nodang/micromouse_hara/README.md

# Micromouse HARA
HARA name comes from [GARA](https://github.com/nodang/LineTracer_Gara).  

HARA is made by [MAZE](https://mazehz.cafe24.com/zbxe/) [25th Roh](https://github.com/nodang) & [28th Cho](https://github.com/cho-hm02123)
