nodang/micromouse_hara/Hara_pcb/Hara/SolidWorks/board_D.DXF

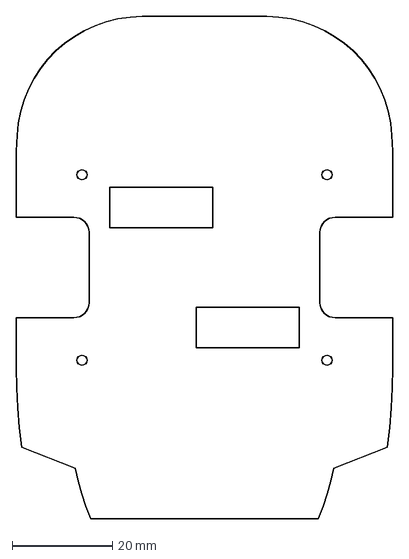
[picture p1: CAD file, 2023-11-28]
Hara_pcb/Hara/SolidWorks/board_D.DXF
75.0 x 100.0 mm
