nodang/micromouse_hara/(list of files, drawings)

Other design files:
Hara_pcb/Hara_v0.4 - cooper-final2.pcb
Hara_pcb/Hara_v0.4 - shape-final.pcb
