nodang/micromouse_hara/2809_hara/main/Variable.h

//###########################################################################
//
// FILE		: Variable.h
//
// TITLE	: Variable.h file.
//
// Author	: Yuk Keun Ho
//
// Company	: Maze & Hz
//
//###########################################################################
// $Release Date: 2011.10.6 $
//###########################################################################



#ifdef _MAIN_
	#ifndef __VARIABLE_EXT__
		#define __VARIABLE_EXT__
	#endif
#else
	#ifndef __VARIABLE_EXT__
		#define __VARIABLE_EXT__	extern
	#endif
#endif	

//==========================================================================//
//                           ROBOT ENVIROMENT                               //
//==========================================================================//

#define BLOCK_WIDTH				_IQ17(180.0)
#define HALF_BLOCK_WIDTH		_IQ17(90.0)
#define BLOCK_WIDTH_DIV2		_IQ17(90.0)
#define BLOCK_INSIDE_WIDTH		_IQ17(168.0)
#define BLOCK_INSIDE_WIDTH_DIV2	_IQ17(84.0)

// width = 81, length 108
#define ROBOT_LENGTH		_IQ17(108.0)
#define ROBOT_LENGTH_DIV2	_IQ17(54.0)
#define ROBOT_WIDTH			_IQ17(81.0)
#define ROBOT_WIDTH_DIV2	_IQ17(40.5)

#define M_PI				3.1415926536

#define TIME_TICK 		_IQ30(0.0005)

//==========================================================================//
//                                 COMMON                                   //
//==========================================================================//

#define FS_TX_PRINT_FLAG	ON

#define	SW_U	(GpioDataRegs.GPADAT.bit.GPIO13)
#define	SW_D	(GpioDataRegs.GPADAT.bit.GPIO26)
#define	SW_R	(GpioDataRegs.GPADAT.bit.GPIO12)
#define	SW_L	(GpioDataRegs.GPBDAT.bit.GPIO32)

#define SW_DELAY		125000
#define SW_DELAY_HALF	62500

/*
#define LED_F	(GpioDataRegs.GPADAT.bit.GPIO23)
#define LED_R	(GpioDataRegs.GPBDAT.bit.GPIO34)
#define LED_L	(GpioDataRegs.GPADAT.bit.GPIO27)

#define BUZZ	(GpioDataRegs.GPBDAT.bit.GPIO33)
*/

#define LED_F_ON 	do {										\
						GpioDataRegs.GPADAT.bit.GPIO23 = ON;	\
					}while(0)
#define LED_F_OFF 	do {										\
						GpioDataRegs.GPADAT.bit.GPIO23 = OFF;	\
					}while(0)
#define LED_R_ON 	do {										\
						GpioDataRegs.GPBDAT.bit.GPIO34 = ON;	\
					}while(0)
#define LED_R_OFF 	do {										\
						GpioDataRegs.GPBDAT.bit.GPIO34 = OFF;	\
					}while(0)
#define LED_L_ON 	do {										\
						GpioDataRegs.GPADAT.bit.GPIO27 = ON;	\
					}while(0)
#define LED_L_OFF 	do {										\
						GpioDataRegs.GPADAT.bit.GPIO27 = OFF;	\
					}while(0)
#define BUZZ_ON 	do {										\
						GpioDataRegs.GPBDAT.bit.GPIO33 = ON;	\
					}while(0)
#define BUZZ_OFF 	do {										\
						GpioDataRegs.GPBDAT.bit.GPIO33 = OFF;	\
					}while(0)

#define SCIA_ISR_ON		do {										\
							SciaRegs.SCICTL2.bit.RXBKINTENA = ON;	\
						}while(0)
#define SCIA_ISR_OFF 	do {										\
							SciaRegs.SCICTL2.bit.RXBKINTENA = OFF;	\
						}while(0)

typedef volatile struct
{
	Uint16	sensor_ir_b:1,			// default: off
			motor_pwm_b:1,			// default: off
			adj_pos_b:1,			// default: off
			motor_dec_sync_b:1;		// default: on
}Flags;

__VARIABLE_EXT__ Flags g_s_flags;

__VARIABLE_EXT__ volatile Uint32 g_timer_500u_u32;

//==========================================================================//
//                                 SENSOR                                   //
//==========================================================================//

#define SEN_NUM			8

#define RBS		g_s_sen[0]	// right back side sensor
#define RFS		g_s_sen[1]	// right front side sensor
#define R45		g_s_sen[2]	// right 45 sensor
#define RF		g_s_sen[3]	// right front sensor
#define LF		g_s_sen[4]	// left front sensor
#define L45		g_s_sen[5]	// left 45 sensor
#define LFS		g_s_sen[6]	// left front side sensor
#define LBS		g_s_sen[7]	// left back side sensor

#define ACTIVATE_SENSOR		do {								\
								g_s_flags.sensor_ir_b = ON;		\
								StartCpuTimer2();				\
							}while(0)

#define DEACTIVATE_SENSOR	do {								\
								StopCpuTimer2();				\
								g_s_flags.sensor_ir_b = OFF;	\
							}while(0)

typedef volatile struct
{
	_iq17	input_q17,
			input_previous_q17,
			output_previous_q17,
			output_q17;			// filtered data
			
}SensorFilterVariable;

typedef volatile struct
{
	_iq17	a0, a1, a2,		// gain
			x0, x1, x2,		// sensor data set
			y0, y1, y2,		// distance set
			x;	// input
}NewtonInterpolationVariable;

typedef volatile struct
{
	NewtonInterpolationVariable s_formula;
	SensorFilterVariable s_filter;

	_iq17 value_q17;	// output
	
}DistanceEstimationVariable;

typedef volatile struct
{
	Uint16	value_u16;

	SensorFilterVariable	s_lpf,
							s_lpf_diff;
	DistanceEstimationVariable	s_dist;

}SensorVariable;

__VARIABLE_EXT__ SensorVariable	g_s_sen[8];

__VARIABLE_EXT__ volatile Uint16	g_sensor_num_u16,
									g_sci_on_u16;

//==========================================================================//
//                                 MOTOR                                    //
//==========================================================================//

#define MAX_VELO	4000
#define MIN_VELO	-MAX_VELO

#define MAX_ACC		16000
#define MIN_ACC		1000		// not meaningful

#define STANDBY_ON 	do {										\
						GpioDataRegs.GPADAT.bit.GPIO22 = ON;	\
					}while(0)
#define STANDBY_OFF do {										\
						GpioDataRegs.GPADAT.bit.GPIO22 = OFF;	\
					}while(0)

#define ACTIVATE_MOTOR		do {									\
								g_s_flags.motor_pwm_b = ON;			\
								STANDBY_ON;							\
								RightQepRegs.QEPCTL.bit.SWI = 1;	\
								LeftQepRegs.QEPCTL.bit.SWI = 1;		\
								StartCpuTimer2();				\
							}while(0)

#define DEACTIVATE_MOTOR	do {								\
								StopCpuTimer2();				\
								STANDBY_OFF;					\
								g_s_flags.motor_pwm_b = OFF;	\
							}while(0)

#define ACTIVATE_MOTOR_ADJ	do {									\
								g_s_flags.motor_pwm_b = ON;			\
								STANDBY_ON;							\
								g_s_flags.adj_pos_b = ON;			\
								RightQepRegs.QEPCTL.bit.SWI = 1;	\
								LeftQepRegs.QEPCTL.bit.SWI = 1;		\
								StartCpuTimer2();					\
							}while(0)

#define DEACTIVATE_MOTOR_ADJ do {								\
								StopCpuTimer2();				\
								g_s_flags.adj_pos_b = OFF;		\
								STANDBY_OFF;					\
								g_s_flags.motor_pwm_b = OFF;	\
							}while(0)

#define ACTIVATE_SYSTEM		do {									\
								g_s_flags.sensor_ir_b = ON;			\
								g_s_flags.motor_pwm_b = ON;			\
								STANDBY_ON;							\
								RightQepRegs.QEPCTL.bit.SWI = 1;	\
								LeftQepRegs.QEPCTL.bit.SWI = 1;		\
								StartCpuTimer2();				\
							}while(0)

#define DEACTIVATE_SYSTEM	do {								\
								StopCpuTimer2();				\
								STANDBY_OFF;					\
								g_s_flags.motor_pwm_b = OFF;	\
								g_s_flags.sensor_ir_b = OFF;	\
							}while(0)


typedef volatile struct
{
	Uint16	sample_u16;
	int16	sample_i16;
	_iq21	sample_q21;
}QEPVariable;

typedef volatile struct
{
	_iq27	tick_q27;

	_iq17	gone_q17,
			target_q17,
			remaining_q17,
			decel_point_q17;
}DistanceVariable;

typedef volatile struct
{
	_iq15	accel_q15;

	_iq17	curr_vel_q17[4],
			curr_vel_avg_q17,
			next_vel_q17,
			target_vel_q17,
			decel_vel_q17;

	Uint16	decel_b:1;
}SpeedVariable;

typedef volatile struct
{
	_iq17	adj_ratio_q17,
			adj_additional_q17,
			adj_add_v_q17;
}AdjustPositionVariable;

typedef volatile struct
{
	QEPVariable s_qep;
	SpeedVariable s_speed;
	DistanceVariable s_dist;
	AdjustPositionVariable s_adj;
	
	_iq17	kp_q17,
			ki_q17,
			kd_q17,
			err_vel_q17[4],
			err_vel_sum_q17,
			proportional_term_q17,
			derivative_term_q17,
			integral_term_q17,
			pid_output_q17;
}MotorVariable;

typedef volatile struct
{
	_iq17	linear_q17,
			angular_q17;
}CommandVelocityVariable;

__VARIABLE_EXT__ MotorVariable	g_s_left_motor,
								g_s_right_motor;

//__VARIABLE_EXT__ CommandVelocityVariable	g_s_cmd_vel;


// Do not reset
__VARIABLE_EXT__ int32	g_ref_vel_i32;

__VARIABLE_EXT__ Uint16	g_accel_u16;
__VARIABLE_EXT__ Uint32	g_motor_kp_u32,
						g_motor_ki_u32,
						g_motor_kd_u32;
// until here

//==========================================================================//
//							 DC MOTOR MODELING                              //
//==========================================================================//

#define STD_TEMP_22	22.0		// Standard Ambient Temperature, 22 Celsisus
#define SUP_VOLT 	7.4			// Nominal Voltage [V]
#define R_STD_TEMP	4.31		// Terminal Resistance [Ohm], Ambient Temp: 22 Celsius
#define L 			0.0000656	// Rotor Inductance [H]
#define k_M			3.96		// Torque Constanct [N*m/A] -> [mN*m/A]
#define k_E			0.000396	// Back EMF Constant [V/(rad/s)] == [N*m/A], This is same as k_M.
#define J			0.000000058	// Rotor Inertia [kg*m^2]
#define M_R			0.18		// Friction Torque [N*m] -> [mN*m]
#define alpha_cu	0.00393		// Temperature Coefficient of Resistance [Celsius]
#define R_th1		13.0		// Winding to Housing Termal Resistance [Ohm]
#define R_th2		2.6			// Housing to Ambient (Metal) [Ohm]
#define tau_w		6.4			// Winding Thermal Time Constant [s]
#define tau_th		20.0		// Housing Thermal time constan [s]
#define C_th1		0.492307692	// Winding Heat Capacity [J/K], tau_w / R_th1
#define C_th2		7.692307692	// Housing Heat Capacity [J/K], tau_th / R_th2

#define RECIP_L			15243.90243	// Reciprocal of Rotor Inductance [1/H]
#define RECIP_R_th1		0.076923076	// Reciprocal of R_th1 [1/Ohm]
#define RECIP_R_th2		0.384615384	// Reciprocal of R_th2 [1/Ohm]
#define RECIP_C_th1		2.031250001	// Reciprocal of C_th1 [1/(J/K)]
#define RECIP_C_th2		0.130000000	// Reciprocal of C_th2 [1/(J/K)]

#define TIME_TICK_DIV_J			8620.689655	// [500us/(kg*m^2)]
#define TIME_TICK_DIV_J_DIV1000	8.620689655	// [500us/(kg*m^2)] /1000 -> [500us/(g*m^2)]

#define MAX_MOTOR_RAD_P_S	1675.516081	// Motor's Angle Speed [rad/s], Max RPM = 16000
#define MIN_MOTOR_RAD_P_S	-MAX_MOTOR_RAD_P_S

#define MAX_MOTOR_TEMP	125.0
#define MIN_MOTOR_TEMP	-30.0

typedef volatile struct {
	_iq27	winding_resistance_q27,
			back_emf_volt_q27,
			control_volt_q27,
			steady_state_current_q27,
			current_q27;	/* -3 ~ 3 */

	_iq25	motor_torque_q25,
			driving_torque_q25,
			friction_torque_q25,
			net_torque_q25;

	_iq19	omega_q19;

	_iq20	power_loss_q20,
			ambient_temp_q20,
		
			heat_flow_winding_to_housing_q20,
			winding_temp_q20,	/* -30 ~ 125 */
			
			heat_flow_housing_to_ambient_q20,
			housing_temp_q20;	/* -30 ~ 125 */
} DCMotorModelVariable;

__VARIABLE_EXT__ DCMotorModelVariable	g_s_left_dc_motor_model;
__VARIABLE_EXT__ DCMotorModelVariable	g_s_right_dc_motor_model;

//==========================================================================//
//                                POSITION                                  //
//==========================================================================//

typedef volatile struct
{
	_iq17	x_q17,
			y_q17,
			th_q17,
			v_q17,
			w_q17;

	_iq17	target_th_q17;
}PositionVariable;

__VARIABLE_EXT__ PositionVariable	g_s_epi, g_s_ref_pos;


//==========================================================================//
//                                ALGORITHM                                 //
//==========================================================================//

#define SIDE		16
#define MAP_SIZE	256

#define NORTH		0x1
#define EAST		0x2
#define SOUTH		0x4
#define WEST		0x8

#define FIND_MAP_INDEX(x, y)	(((x << 4) & 0xf0) | (y & 0x0f))
#define FIND_X_FROM_INDEX(ind)	((ind & 0xf0) >> 4)
#define FIND_Y_FROM_INDEX(ind)	(ind & 0x0f)

#define MAX_COST_8UL	255

typedef union {
	int16 all;
	struct {
		int16 north:1;
		int16 east:1;
		int16 south:1;
		int16 west:1;
		int16 rsvd:4;
	}bit;
}Map;
/*
typedef struct {
	int16 x;
	int16 y;
}Coord;
*/
typedef struct {
	int16 pos;
	int16 dir;
}Robot;

typedef struct {
	int16 arr[MAP_SIZE];
	int16 ind;
}QueueType;

typedef struct {
	int16 cost[MAP_SIZE + 1];
	int16 node[MAP_SIZE + 1];
	int16 heap_size;
}HeapType;

enum GoalNode
{
	HOME = 0x00,

	GOAL_1 = 0x77,
	GOAL_2 = 0x87,
	GOAL_3 = 0x78,
	GOAL_4 = 0x88
};

enum CoordinateDifference
{
	PLUS_X = 0x10,
	PLUS_Y = 0x01,

	MINUS_X = -0x10,
	MINUS_Y = -0x01,

	PLUS_X_Y = 0x11,
	PLUS_X_MINUS_Y = 0x0f,
	MINUS_X_PLUS_Y = -0x0f,
	MINUS_X_Y = -0x11
};

__VARIABLE_EXT__ HeapType pq;
__VARIABLE_EXT__ Map map[MAP_SIZE];	//origin_map[MAP_SIZE]
__VARIABLE_EXT__ QueueType queue, path;
__VARIABLE_EXT__ Robot robot;

__VARIABLE_EXT__ int16 visit[MAP_SIZE], closed[MAP_SIZE];
// cost function = heuristics function + gone function
__VARIABLE_EXT__ int16 cost[MAP_SIZE], g[MAP_SIZE], h[MAP_SIZE];

__VARIABLE_EXT__ int16 past_node[MAP_SIZE], goal_node[4];

// the order of diff matches north, east, south, west.
__VARIABLE_EXT__ int16 diff[4], diff_eight[8];
