nodang/micromouse_hara/2809_hara/main/menu.h

//###########################################################################
//
// FILE		: Menu.h
//
// TITLE	: Menu h file.
//
// Author	: Yuk Keun Ho
//
// Company	: MAZE
//
//###########################################################################
// $Release Date: 2011.11.16 $
//###########################################################################

#ifndef __MENU_H__
#define __MENU_H__

extern void Menu(void);

#endif
