nodang/micromouse_hara/(commit log)

2023-11-28 Nov 28, 2023. init hara project.
    [DSP280x_Adc.obj, DSP280x_CodeStartBranch.obj, DSP280x_CpuTimers.obj, DSP280x_DefaultIsr.obj, DSP280x_EPwm.obj, DSP280x_EQep.obj, DSP280x_GlobalVariableDefs.obj, DSP280x_Gpio.obj]
2024-03-01 Mar 1, 2024. Deleted file formats for asm and obj. because they should have been ignored
    [DSP280x_Adc.obj, DSP280x_CodeStartBranch.obj, DSP280x_CpuTimers.obj, DSP280x_DefaultIsr.obj, DSP280x_EPwm.obj, DSP280x_EQep.obj, DSP280x_GlobalVariableDefs.obj, DSP280x_Gpio.obj]
2024-03-03 Mar 3, 2024. Modified variable names for according to Google C language naming style.
    1. The declaration type of variable must follow the name.
    2. The name of structure must start with "s_".
    3. The name of global variable must start with "g_".
    4. If the variable is a global variable of sturcture type, it must start with "g_s_".
    5. Enumeration type and sturcture type must be named Pascal case.
    6. The name of enumeration type must start with 'e'.
    7. Constant type variable or enumeration value must start with 'k'.
    8. Exceptionally, constant variable must be named Pascal case.
2024-05-19 Mar 3, 2024. Modified motor variables structure. And, sensor gpio and adc seq marco are changed to enum type.
2024-06-10 Jun 10, 2024. Hara PBC is completed, v1.0.
    [Hara_v0.4 - cooper-final2.pcb, Hara_v0.4 - shape-final.pcb]
2024-06-14 Jun 15, 2024. Modifying the motor control according to turn simulation on Colab.
2024-06-15 Jun 15, 2024. 1. Modified gitignore to include hex file 2. Modified menu to test motor control and calibrate param for motor control (init version)
2024-06-15 Jun 15, 2024. 1. Suspended the test code and activate menu code 2. Initial code is updated for motor test
2024-06-15 Jun 16, 2024. Made menu for testing 1. Switch GPIO settings is modified. because Left SW was not operated. 2. Global variables about "don't reset" is initialized when main function is called.
    Issue
    Left SW and Down SW operate both.
    Need to find what is wrong. SW seems like nothing wrong. Maybe HW..
    [Variable.h, main.c, menu.c, sensor.c]
2024-06-16 Jun 16, 2024. Added motor test code and detect swtich error. SW_D and SW_L is close, so it seems HW error.
    [menu.c]
2024-06-29 Jun 29, 2024. Making motor test code now
2024-06-29 Jun 29, 2024. Cleaned sensor variables.
    1. modified position > dist in senser variables structure.
    2. Deleted structure pointers of each sensers.
2024-07-06 Jul 6, 2024. Added distance estimation depends on sensor data
2024-07-07 Jul 6, 2024. modified for motor test.
    1. in motor.c, target_vel = decel_vel's condition is strange. so, added FALSE in condition.
    2. adjust gain was zero. so modified initial value is set as _IQ17(1.0).
2024-07-08 Jul 8, 2024. Modified for estimating dist logic and calibrating sensor
    1. Added 500u timer cnt
    2. Added motor decel flag
    Todo: need to be fixed move to stop logic
    if curr_v > 0 & tar_v > curr_v & dec_v == 0
    - need to calculate decel_point
    [Motor.c, Variable.h, sensor.c, sensor.h]
2024-07-09 Jul 9, 2024. Added move_to_end and move_to_move function in Motor.c
    1. in move_to_~ function, they have calculating inline functions to calculate decel_dist
    2. if decel_dist + accel_dist > target_dist then calculate target_vel again
2024-07-09 Jul 9, 2024. Added sensor setting function
    1. in motor.c, modified to be used _IQ17abs
    2. in sensor.c added automatic sensor setting about diagoanl and front sensor
2024-07-14 July 14, 2024. Deleted unused files and modified for motor test
    1. Added ram section of motor ISR and sensor ISR
    2. Deleted flash and Struct
2024-07-21 Jul 21, 2024. Fixed bugs
    1. In sensor interrupt, modified correctly about sum sensor datas
    2. In motor test, modified as target accel is applied
    [Motor.c, Variable.h, menu.c, sensor.c]
2024-07-22 July 22, 2024.
    1. Added code that sensor store to rom and read from rom
    2. still making poisition estimation code
    3. sensor setting code is changed
2024-08-06 Aug 7, 2024. Added algorithm for racing.
    Todo
    1. Turn logic when the next direction is different to current direction.
    2. move2move
    3. Save wall data logic
2024-08-10 Aug 10, 2024. fixed motor pid and wrong code.
    [Motor.c, Rom.c, Variable.h, main.c, menu.c, position.c, sensor.c]
2024-08-10 Aug 11. 2024. start fixing bug
    [algo.c, race.c, sensor.c]
2024-08-12 Aug 13. fixed decel dist calculation function in movetostop and movetomove.
    1. More correctly. There is some diff-error in decel dist calculation function.
    2. need to turn move function (in sensor setting-front45)
    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
    [Motor.c, Motor.h, Variable.h, main.c, menu.c, race.c, sensor.c]
2024-08-13 Aug 14. fixed decel dist calculation function in movetostop and movetomove. Error ratio is less then 5%.
    1. need to make move done flag
    2. need to naje turn move function (in sensor setting-front45)
    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
    [Motor.c]
2024-08-15 Aug 15, 2024. Added turn function in place.
    1. InPlaceTurn function is needed to more clarify
    2. need to make move done flag
    3. need to naje turn move function (in sensor setting-front45)
    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
2024-08-18 Aug 18, 2024. Added calibration of motor PID
    Todo.
    1. same before
    2. same before
    3. Caliabrate motor PID coef
2025-07-27 July 27, 2025. Updated the instuction pptx file for analysis of motor torque.
2025-07-27 July 27, 2025. Updating Motor.c for implementation of dc motor model simulation on MCU.
2025-08-05 Aug 5, 2025. Update DC Motor Model Simulation, Need to update Motor Controller.
2025-08-05 Aug 6, 2025. Designing SMC(sliding mode controller) for motor control.
2025-08-08 Aug 8, 2025. The motor controller with calculating motor-torque and current is not accurate. It will be changed.
